ArCo38/Sensors_and_Controls_Board/PCB_Files/Sensor_Integration_Board.kicad_pcb

## KiCad design PCB_Files/Sensor_Integration_Board.kicad_pcb (2026-11-14)

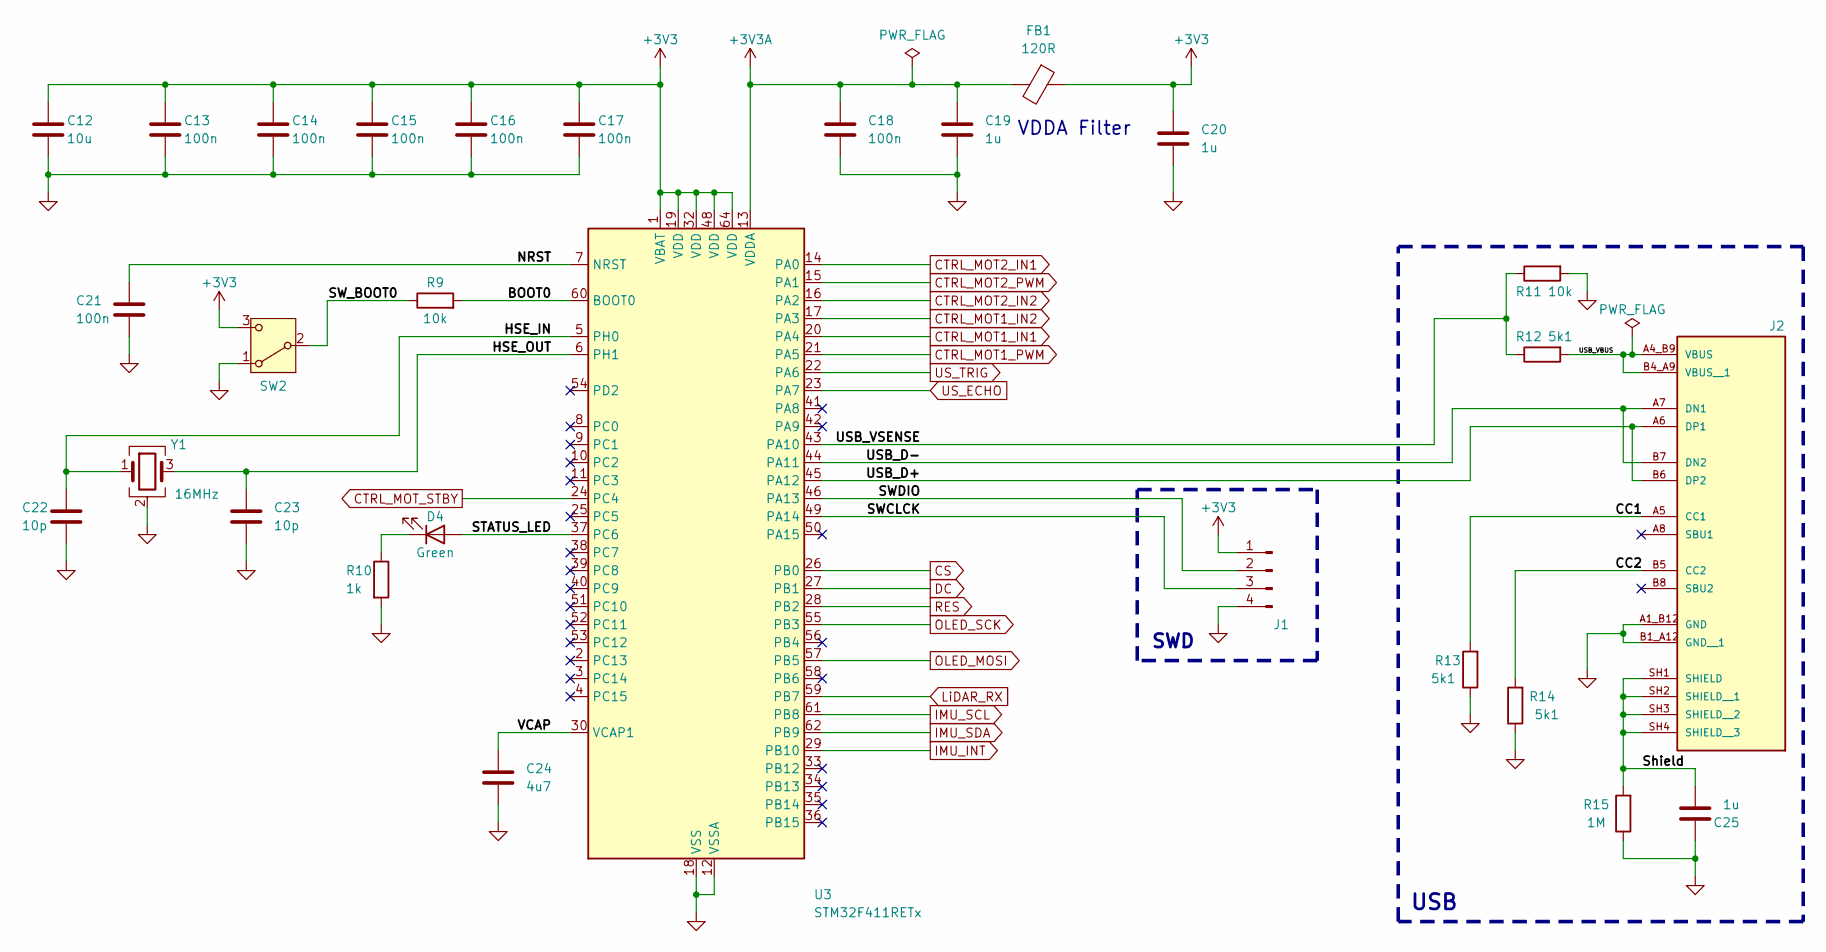
[picture p1: schematic MCU_Schematic.kicad_sch]

Parts:
C12: 10u; C_0805_2012Metric
C13, C14, C15, C16, C17, C18, C21: 100n; C_0603_1608Metric
C19, C20, C25: 1u; C_0805_2012Metric
C22, C23: 10p; C_0603_1608Metric
C24: 4u7; C_0805_2012Metric
D4: Green; LED_0603_1608Metric
FB1: 120R; L_0603_1608Metric
J1: SWD; PinHeader_1x04_P2.54mm_Vertical
J2: UJ20-C-H-G-SMT-4-P16-TR; SAMESKY_UJ20-C-H-G-SMT-4-P16-TR; PARTREV 1.0
R9, R11: 10k; R_0603_1608Metric
R10: 1k; R_0603_1608Metric
R12, R13, R14: 5k1; R_0603_1608Metric
R15: 1M; R_0603_1608Metric
SW2: SW_SPDT; SW_1218_EWI
U3: STM32F411RETx; LQFP-64_10x10mm_P0.5mm
Y1: 16MHz; Crystal_SMD_SeikoEpson_TSX3225-4Pin_3.2x2.5mm

Connections:
+3V3: C12.1, C13.1, C14.1, C15.1, C16.1, C17.1, C20.1, FB1.1, J1.1, SW2.3 (C), U3.1 (VBAT), U3.19 (VDD), U3.32 (VDD), U3.48 (VDD), U3.64 (VDD); also elsewhere on the board
+3V3A: C18.1, C19.1, FB1.2, U3.13 (VDDA)
/MicroController/BOOT0: R9.2, U3.60 (BOOT0)
/MicroController/CC1: J2.A5 (CC1), R13.2
/MicroController/CC2: J2.B5 (CC2), R14.2
/MicroController/HSE_IN: C22.1, U3.5 (PH0), Y1.1
/MicroController/HSE_OUT: C23.1, U3.6 (PH1), Y1.3
/MicroController/NRST: C21.1, U3.7 (NRST)
/MicroController/STATUS_LED: D4.2 (A), U3.37 (PC6)
/MicroController/SWCLCK: J1.3, U3.49 (PA14)
/MicroController/SWDIO: J1.2, U3.46 (PA13)
/MicroController/SW_BOOT0: R9.1, SW2.2 (B)
/MicroController/Shield: C25.1, J2.SH1 (SHIELD), J2.SH2 (SHIELD__1), J2.SH3 (SHIELD__2), J2.SH4 (SHIELD__3), R15.2
/MicroController/USB_D+: J2.A6 (DP1), J2.B6 (DP2), U3.45 (PA12)
/MicroController/USB_D-: J2.A7 (DN1), J2.B7 (DN2), U3.44 (PA11)
/MicroController/USB_VBUS: J2.A4_B9 (VBUS), J2.B4_A9 (VBUS__1), R12.2
/MicroController/USB_VSENSE: R11.1, R12.1, U3.43 (PA10)
/MicroController/VCAP: C24.2, U3.30 (VCAP1)
CS: U3.26 (PB0); also elsewhere on the board
CTRL_MOT1_IN1: U3.20 (PA4); also elsewhere on the board
CTRL_MOT1_IN2: U3.17 (PA3); also elsewhere on the board
CTRL_MOT1_PWM: U3.21 (PA5); also elsewhere on the board
CTRL_MOT2_IN1: U3.14 (PA0); also elsewhere on the board
CTRL_MOT2_IN2: U3.16 (PA2); also elsewhere on the board
CTRL_MOT2_PWM: U3.15 (PA1); also elsewhere on the board
CTRL_MOT_STBY: U3.24 (PC4); also elsewhere on the board
DC: U3.27 (PB1); also elsewhere on the board
GND: C12.2, C13.2, C14.2, C15.2, C16.2, C17.2, C18.2, C19.2, C20.2, C21.2, C22.2, C23.2, C24.1, C25.2, J1.4, J2.A1_B12 (GND), J2.B1_A12 (GND__1), R10.2, R11.2, R13.1, R14.1, R15.1, SW2.1 (A), U3.12 (VSSA), U3.18 (VSS), U3.31 (VSS), U3.47 (VSS), U3.63 (VSS), Y1.2 (G), Y1.4 (G); also elsewhere on the board
IMU_INT: U3.29 (PB10); also elsewhere on the board
IMU_SCL: U3.61 (PB8); also elsewhere on the board
IMU_SDA: U3.62 (PB9); also elsewhere on the board
LiDAR_RX: U3.59 (PB7); also elsewhere on the board
unnamed: D4.1 (K), R10.1
OLED_MOSI: U3.57 (PB5); also elsewhere on the board
OLED_SCK: U3.55 (PB3); also elsewhere on the board
RES: U3.28 (PB2); also elsewhere on the board
US_ECHO: U3.23 (PA7); also elsewhere on the board
US_TRIG: U3.22 (PA6); also elsewhere on the board

Notes on the sheet:
USB
SWD
VDDA Filter

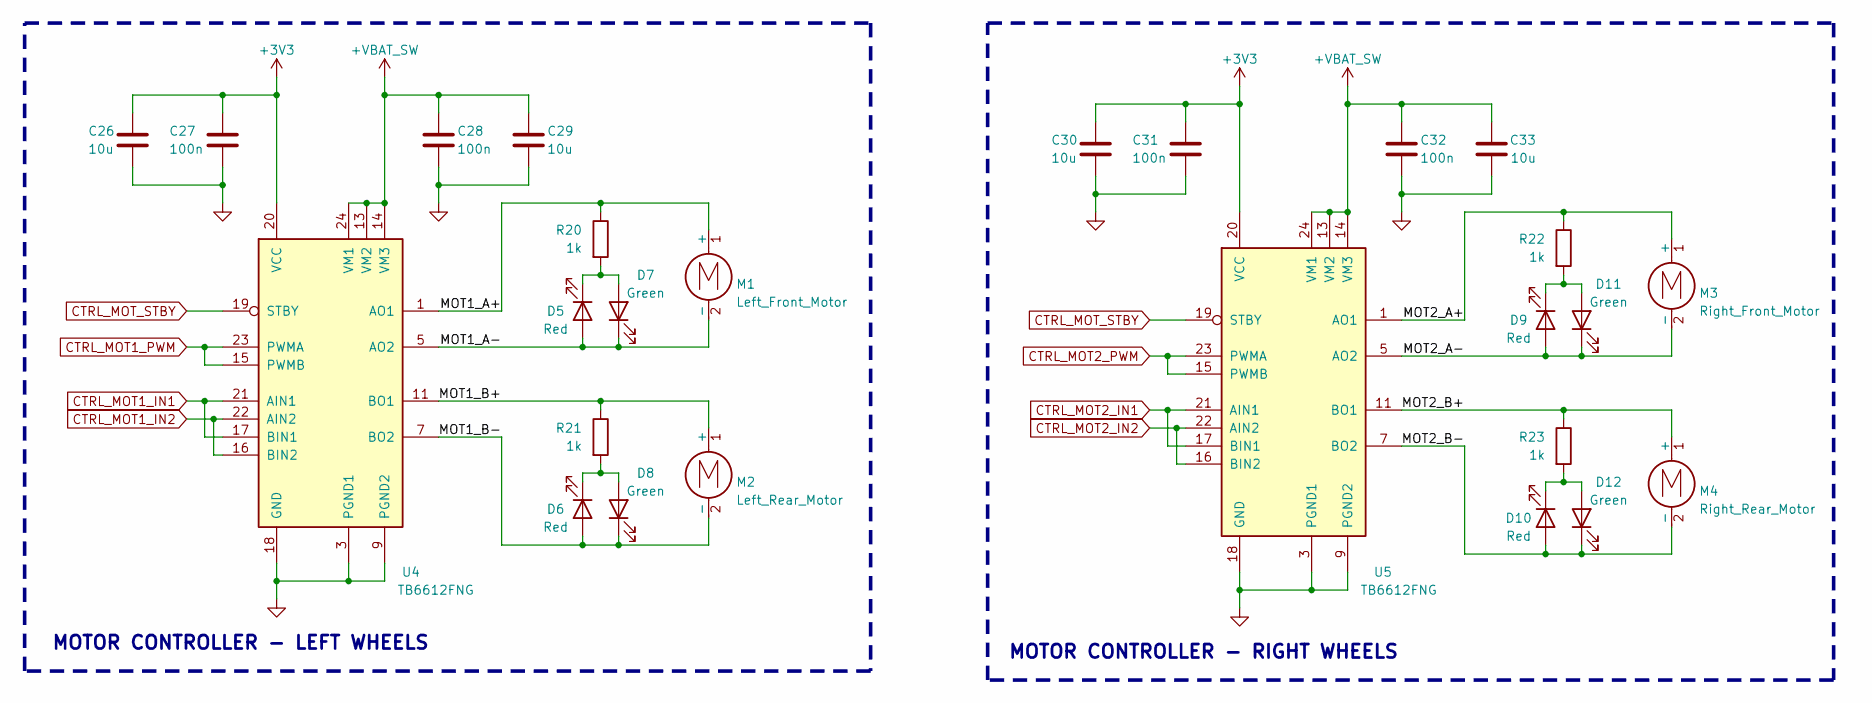
[picture p2: schematic Motor_Controls.kicad_sch]

Parts:
C26, C29, C30, C33: 10u; C_0805_2012Metric
C27, C28, C31, C32: 100n; C_0603_1608Metric
D5, D6, D9, D10: Red; LED_0603_1608Metric
D7, D8, D11, D12: Green; LED_0603_1608Metric
M1: Left_Front_Motor; JST_XH_B2B-XH-A_1x02_P2.50mm_Vertical
M2: Left_Rear_Motor; JST_XH_B2B-XH-A_1x02_P2.50mm_Vertical
M3: Right_Front_Motor; JST_XH_B2B-XH-A_1x02_P2.50mm_Vertical
M4: Right_Rear_Motor; JST_XH_B2B-XH-A_1x02_P2.50mm_Vertical
R20, R21, R22, R23: 1k; R_0603_1608Metric
U4, U5: TB6612FNG; SSOP-24_5.3x8.2mm_P0.65mm

Connections:
+3V3: C26.1, C27.1, C30.1, C31.1, U4.20 (VCC), U5.20 (VCC); also elsewhere on the board
+VBAT_SW: C28.1, C29.1, C32.1, C33.1, U4.13 (VM2), U4.14 (VM3), U4.24 (VM1), U5.13 (VM2), U5.14 (VM3), U5.24 (VM1); also elsewhere on the board
/Motor_Controls/MOT1_A+: M1.1 (+), R20.1, U4.1 (AO1), U4.2 (AO1)
/Motor_Controls/MOT1_A-: D5.2 (A), D7.1 (K), M1.2 (-), U4.5 (AO2), U4.6 (AO2)
/Motor_Controls/MOT1_B+: M2.1 (+), R21.1, U4.11 (BO1), U4.12 (BO1)
/Motor_Controls/MOT1_B-: D6.2 (A), D8.1 (K), M2.2 (-), U4.7 (BO2), U4.8 (BO2)
/Motor_Controls/MOT2_A+: M3.1 (+), R22.1, U5.1 (AO1), U5.2 (AO1)
/Motor_Controls/MOT2_A-: D9.2 (A), D11.1 (K), M3.2 (-), U5.5 (AO2), U5.6 (AO2)
/Motor_Controls/MOT2_B+: M4.1 (+), R23.1, U5.11 (BO1), U5.12 (BO1)
/Motor_Controls/MOT2_B-: D10.2 (A), D12.1 (K), M4.2 (-), U5.7 (BO2), U5.8 (BO2)
CTRL_MOT1_IN1: U4.17 (BIN1), U4.21 (AIN1); also elsewhere on the board
CTRL_MOT1_IN2: U4.16 (BIN2), U4.22 (AIN2); also elsewhere on the board
CTRL_MOT1_PWM: U4.15 (PWMB), U4.23 (PWMA); also elsewhere on the board
CTRL_MOT2_IN1: U5.17 (BIN1), U5.21 (AIN1); also elsewhere on the board
CTRL_MOT2_IN2: U5.16 (BIN2), U5.22 (AIN2); also elsewhere on the board
CTRL_MOT2_PWM: U5.15 (PWMB), U5.23 (PWMA); also elsewhere on the board
CTRL_MOT_STBY: U4.19 (STBY), U5.19 (STBY); also elsewhere on the board
GND: C26.2, C27.2, C28.2, C29.2, C30.2, C31.2, C32.2, C33.2, U4.3 (PGND1), U4.4 (PGND1), U4.9 (PGND2), U4.10 (PGND2), U4.18 (GND), U5.3 (PGND1), U5.4 (PGND1), U5.9 (PGND2), U5.10 (PGND2), U5.18 (GND); also elsewhere on the board
unnamed: D5.1 (K), D7.2 (A), R20.2
unnamed: D6.1 (K), D8.2 (A), R21.2
unnamed: D10.1 (K), D12.2 (A), R23.2
unnamed: D9.1 (K), D11.2 (A), R22.2

Notes on the sheet:
MOTOR CONTROLLER - LEFT WHEELS
MOTOR CONTROLLER - RIGHT WHEELS

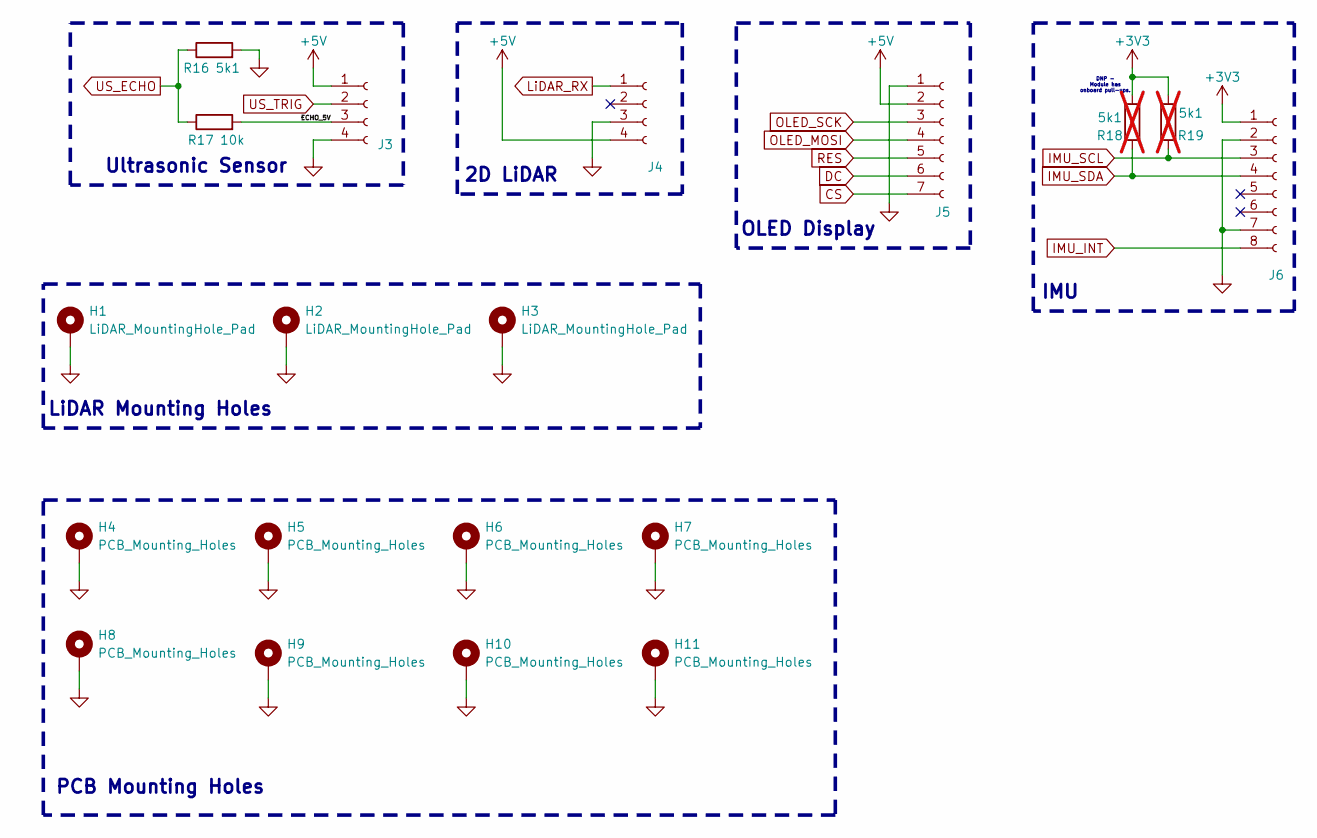
[picture p3: schematic Sensors_and_Peripherals.kicad_sch]

Parts:
H1, H2, H3: LiDAR_MountingHole_Pad; MountingHole_2.7mm_Pad_Via
H4, H5, H6, H7, H8, H9, H10, H11: PCB_Mounting_Holes; MountingHole_3.2mm_M3_Pad_Via
J3: Ultrasonic_Sensor; PinSocket_1x04_P2.54mm_Vertical
J4: 2D_LiDAR; JST_ZH_B4B-ZR_1x04_P1.50mm_Vertical
J5: OLED_Display; PinSocket_1x07_P2.54mm_Vertical
J6: IMU; PinSocket_1x08_P2.54mm_Vertical
R16: 5k1; R_0603_1608Metric
R17: 10k; R_0603_1608Metric
R18, R19: 5k1; R_0603_1608Metric; not fitted

Connections:
+3V3: J6.1, R18.1, R19.1; also elsewhere on the board
+5V: J3.1, J4.4, J5.2; also elsewhere on the board
/Sensors_and_Peripherals/ECHO_5V: J3.3, R17.2
CS: J5.7; also elsewhere on the board
DC: J5.6; also elsewhere on the board
GND: H1.1 (1_1), H2.1 (1_1), H3.1 (1_1), H4.1 (1_1), H5.1 (1_1), H6.1 (1_1), H7.1 (1_1), H8.1 (1_1), H9.1 (1_1), H10.1 (1_1), H11.1 (1_1), J3.4, J4.3, J5.1, J6.2, J6.7, R16.2; also elsewhere on the board
IMU_INT: J6.8; also elsewhere on the board
IMU_SCL: J6.3, R19.2; also elsewhere on the board
IMU_SDA: J6.4, R18.2; also elsewhere on the board
LiDAR_RX: J4.1; also elsewhere on the board
OLED_MOSI: J5.4; also elsewhere on the board
OLED_SCK: J5.3; also elsewhere on the board
RES: J5.5; also elsewhere on the board
US_ECHO: R16.1, R17.1; also elsewhere on the board
US_TRIG: J3.2; also elsewhere on the board

Notes on the sheet:
2D LiDAR
IMU
OLED Display
LiDAR Mounting Holes
Ultrasonic Sensor
PCB Mounting Holes
DNP - Module has onboard pull-ups.

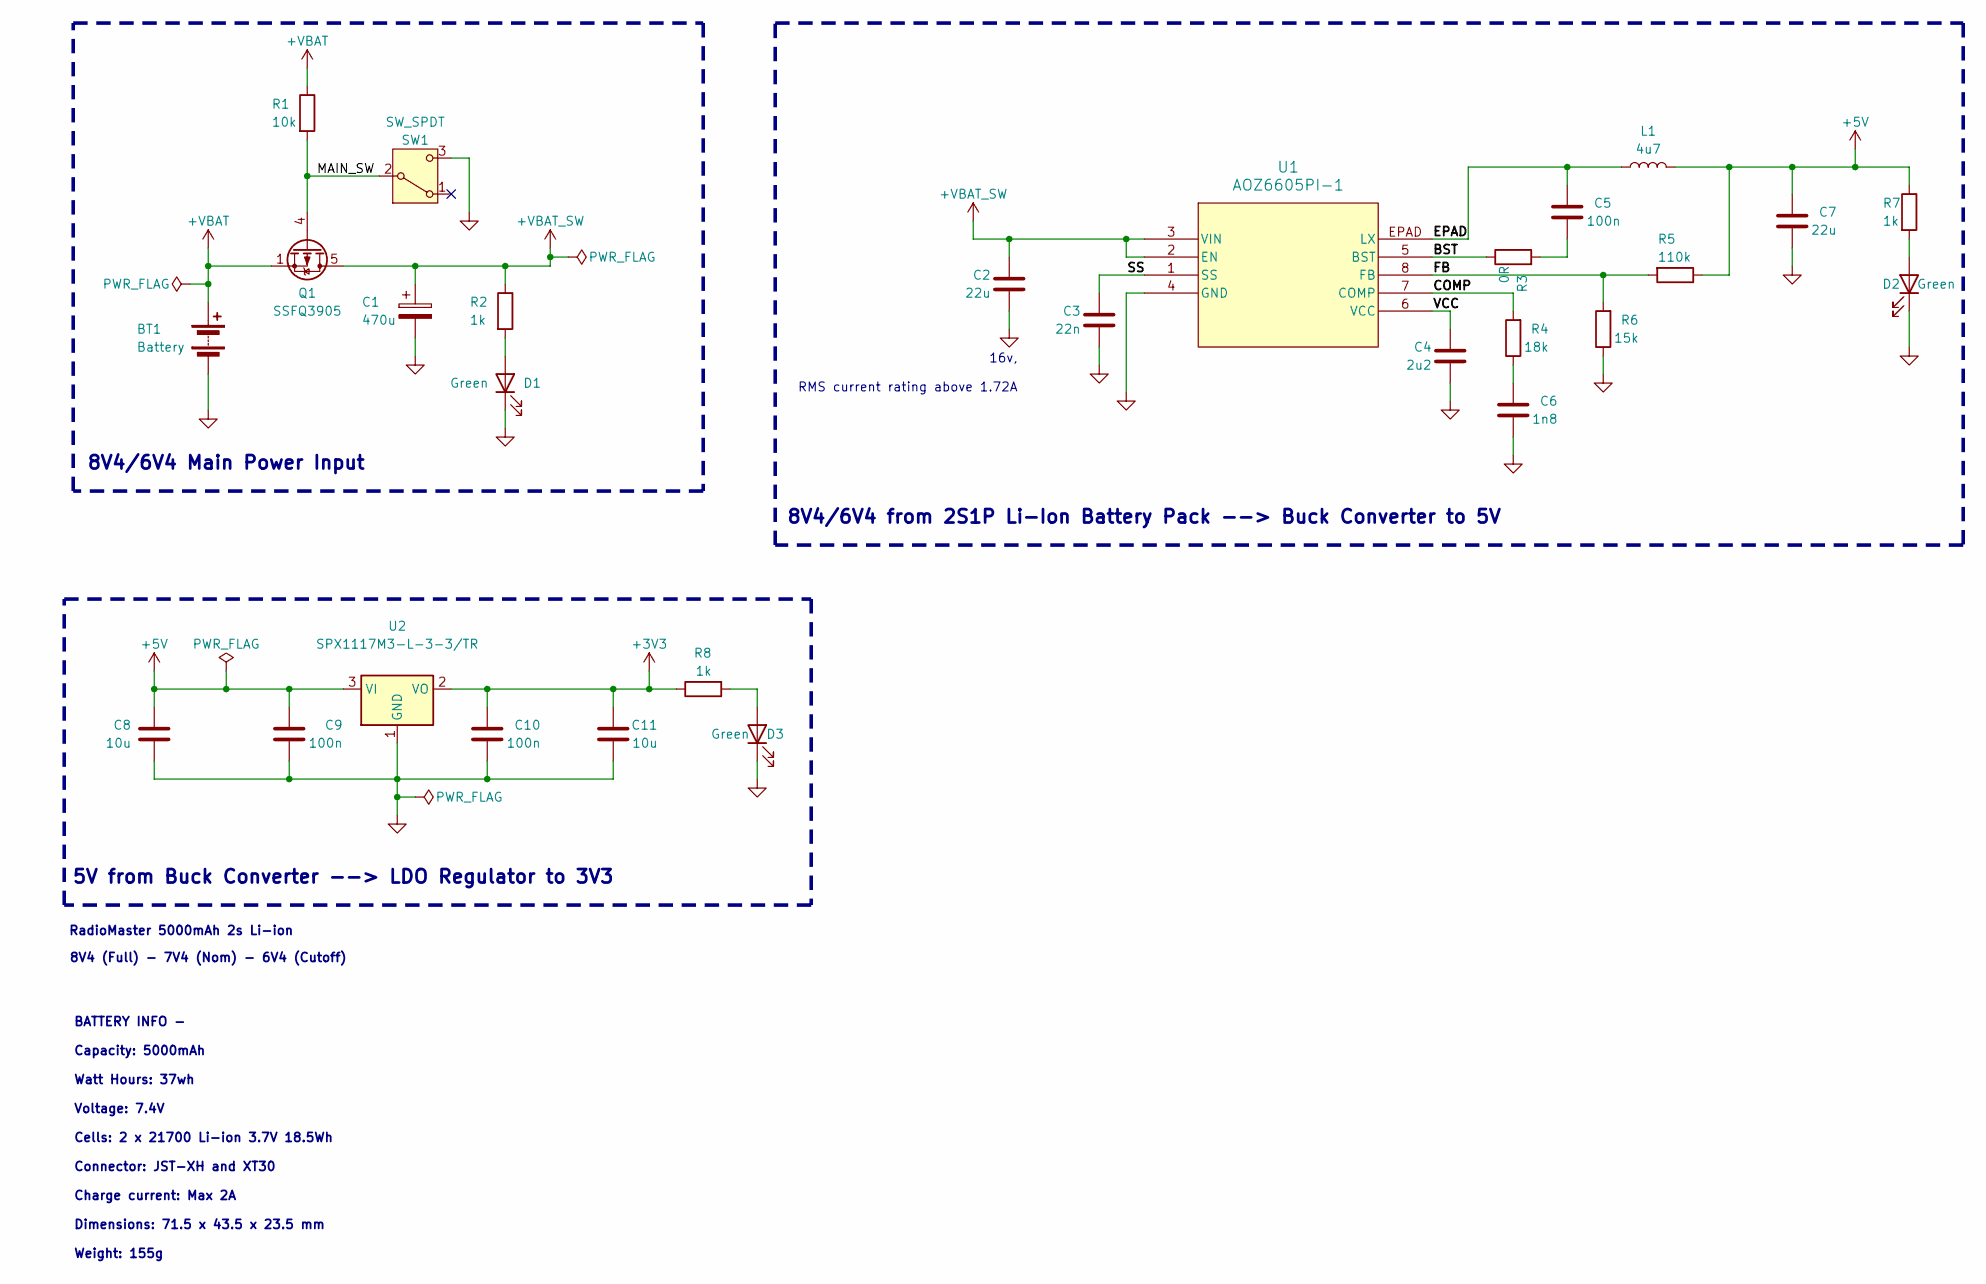
[picture p4: schematic Power_Delivery.kicad_sch]

Parts:
BT1: Battery; AMASS_XT30UPB-M_1x02_P5.0mm_Vertical
C1: 470u; C_0805_2012Metric
C2, C7: 22u; C_0805_2012Metric
C3: 22n; C_0603_1608Metric
C4: 2u2; C_0805_2012Metric
C5, C9, C10: 100n; C_0603_1608Metric
C6: 1n8; C_0603_1608Metric
C8, C11: 10u; C_0805_2012Metric
D1, D2, D3: Green; LED_0603_1608Metric
L1: 4u7; L_0603_1608Metric
Q1: SSFQ3905; SOIC-8_3.9x4.9mm_P1.27mm
R1: 10k; R_0603_1608Metric
R2, R7, R8: 1k; R_0603_1608Metric
R3: 0R; R_0603_1608Metric
R4: 18k; R_0603_1608Metric
R5: 110k; R_0603_1608Metric
R6: 15k; R_0603_1608Metric
SW1: SW_SPDT; SW_1218_EWI
U1: AOZ6605PI-1; SO8_EP1_AOS
U2: SPX1117M3-L-3-3/TR; SOT-223-3_TabPin2

Connections:
+3V3: C10.1, C11.1, R8.1, U2.2 (VO); also elsewhere on the board
+5V: C7.1, C8.1, C9.1, L1.2, R5.1, R7.1, U2.3 (VI); also elsewhere on the board
+VBAT: BT1.1 (+), Q1.1 (S), Q1.2 (S), Q1.3 (S), R1.1
+VBAT_SW: C1.1, C2.1, Q1.5 (D), Q1.6 (D), Q1.7 (D), Q1.8 (D), R2.1, U1.2 (EN), U1.3 (VIN); also elsewhere on the board
/Power_Delivery/BST: R3.1, U1.5 (BST)
/Power_Delivery/COMP: R4.2, U1.7 (COMP)
/Power_Delivery/EPAD: C5.2, L1.1, U1.EPAD (LX)
/Power_Delivery/FB: R5.2, R6.2, U1.8 (FB)
/Power_Delivery/MAIN_SW: Q1.4 (G), R1.2, SW1.2 (B)
/Power_Delivery/SS: C3.1, U1.1 (SS)
/Power_Delivery/VCC: C4.1, U1.6 (VCC)
GND: BT1.2 (-), C1.2, C2.2, C3.2, C4.2, C6.2, C7.2, C8.2, C9.2, C10.2, C11.2, D1.1 (K), D2.1 (K), D3.1 (K), R6.1, SW1.3 (C), U1.4 (GND), U2.1 (GND); also elsewhere on the board
unnamed: C5.1, R3.2
unnamed: C6.1, R4.1
unnamed: D1.2 (A), R2.2
unnamed: D2.2 (A), R7.2
unnamed: D3.2 (A), R8.2

Notes on the sheet:
8V4 (Full) - 7V4 (Nom) - 6V4 (Cutoff)
5V from Buck Converter --> LDO Regulator to 3V3
8V4/6V4 Main Power Input
RadioMaster 5000mAh 2s Li-ion
16v, RMS current rating above 1.72A
BATTERY INFO - Capacity: 5000mAh Watt Hours: 37wh Voltage: 7.4V Cells: 2 x 21700 Li-ion 3.7V 18.5Wh Connector: JST-XH and XT30 Charge current: Max 2A Dimensions: 71.5 x 43.5 x 23.5 mm Weight: 155g
8V4/6V4 from 2S1P Li-Ion Battery Pack --> Buck Converter to 5V

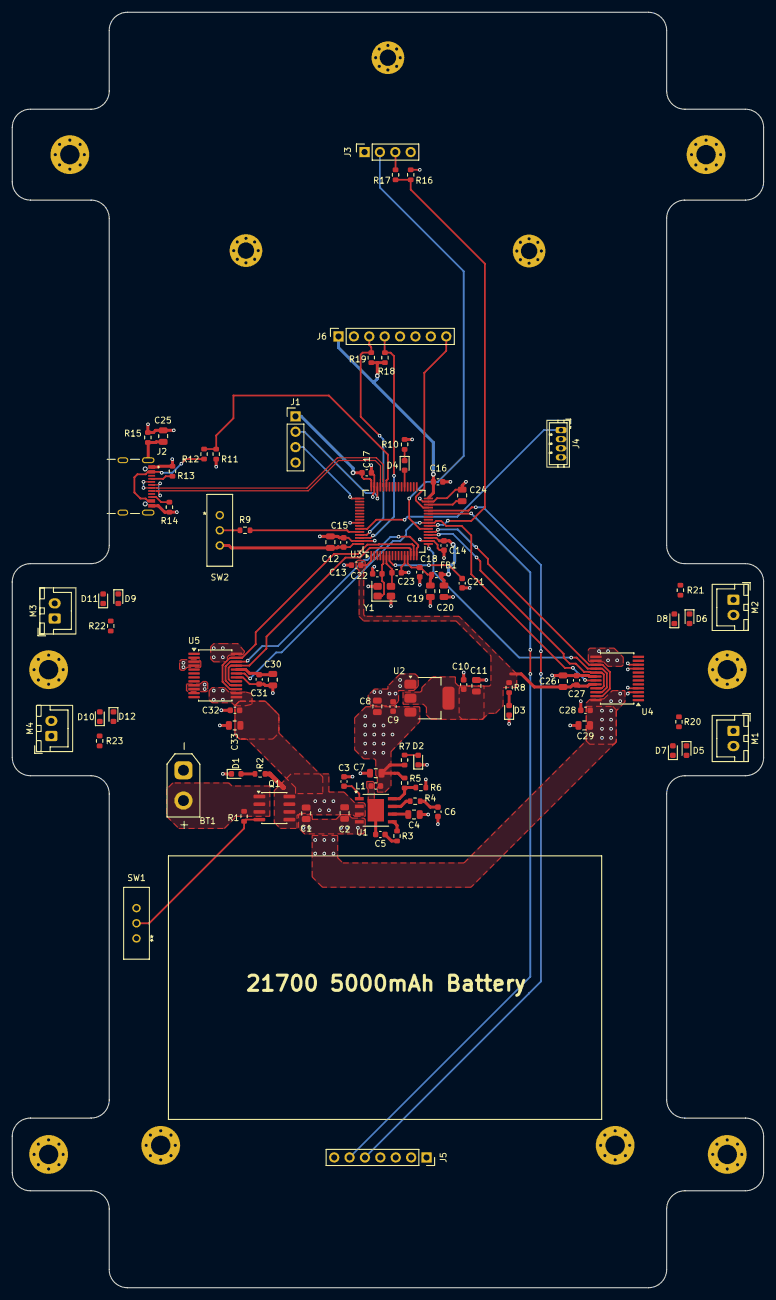
[picture p5: board Sensor_Integration_Board.kicad_pcb from above]

Board: 4 copper layers, 124.0 x 210.5 mm, 101 parts (0 on the bottom side), 66 nets.
