ArCo38/Sensors_and_Controls_Board/firmware/Sensor_Integration_MCU_Config.ioc

Mcu.UserName=STM32F411RETx
PA1.Signal=S_TIM2_CH2
PA11.Signal=USB_OTG_FS_DM
PA12.Signal=USB_OTG_FS_DP
PA13.Signal=SYS_JTMS-SWDIO
PA14.Signal=SYS_JTCK-SWCLK
PA5.Signal=S_TIM2_CH1_ETR
PA7.Signal=S_TIM3_CH2
PB10.Signal=I2C2_SCL
PB3.Signal=SPI1_SCK
PB5.Signal=SPI1_MOSI
PB6.Signal=USART1_TX
PB7.Signal=USART1_RX
PB9.Signal=I2C2_SDA
