ArCo38/Sensors_and_Controls_Board/(commit log)

2026-10-21 feat: initial commit of sensor integration board hardware and mcu configs
    [MCU_Schematic.kicad_sch, Motor_Controls.kicad_sch, Power_Delivery.kicad_sch, Sensor_Integration_Board.kicad_pcb, Sensor_Integration_Board.kicad_sch]
2026-10-21 Swapped all +3.3V and +3.3VA labels to +3V3 and +3V3A lables for clarity.
    [MCU_Schematic.kicad_sch]
2026-10-21 chore: remove KiCad auto-backups from version control
2026-10-23 Changed pin names on MCU sheet for clarity. Example: US_TIM3_CH1 to US_ECHO
    [MCU_Schematic.kicad_sch]
2026-10-24 Began laying out power schematic and motor controller schematic
    [MCU_Schematic.kicad_sch, Motor_Controls.kicad_sch, Power_Delivery.kicad_sch]
2026-10-26 Completed power schematic page. 2S LiPo to buck module to LDO regulator for 3.3v
    [MCU_Schematic.kicad_sch, Power_Delivery.kicad_sch]
2026-10-27 Completed motor control schematic sheet and related MCU pin outs.
    [MCU_Schematic.kicad_sch, Motor_Controls.kicad_sch]
2026-10-27 Cleaned up all ERC errors and warnings due to missing Power Flags or misaligned grid.
    [MCU_Schematic.kicad_sch, Motor_Controls.kicad_sch, Power_Delivery.kicad_sch]
2026-10-27 General schematic clean up and footprint allocation.
    [MCU_Schematic.kicad_sch, Motor_Controls.kicad_sch, Power_Delivery.kicad_sch, Sensor_Integration_Board.kicad_sch]
2026-10-27 Cleaned up battery to buck convertor schematic and added 470u polarized capacitor as a bulk power reservoir.
2026-10-27 Added RadioMaster 2S Battery information to power schematic sheet.
    [Motor_Controls.kicad_sch, Power_Delivery.kicad_sch]
2026-10-28 Cleaned up MCU sheet, added bounding boxes for peripherals.
    [Power_Delivery.kicad_sch]
2026-10-28 Added indicator and debug LED's to various outputs such as buck VOUT, ldo regulator VOUT, motor outputs, and status LED for MCU.
    [MCU_Schematic.kicad_sch, Motor_Controls.kicad_sch, Power_Delivery.kicad_sch]
2026-10-28 Cleaned up MCU schematic by removing speghetti wires and using local net labels instead (Only for some peripherals like sensors and USB.)
    [MCU_Schematic.kicad_sch]
2026-10-28 Cleaned up MCU schematic by seperating power decoupling and main MCU. Added bounding boxes and labels to MCU power decoupling and the MCU itself.
    [MCU_Schematic.kicad_sch]
2026-10-29 Added DNP to IMU pull up resistors due to already being on the module.
    [MCU_Schematic.kicad_sch, Power_Delivery.kicad_sch]
2026-10-29 Cleaned up Bi-directional LED indicator schematic layout for motor controllers.
    [Motor_Controls.kicad_sch, Power_Delivery.kicad_sch]
2026-10-29 Cleaned up motor controller schematic by seperating power decoupling for both motor controllers, seperated SGND and PGND, and rearranged input pin wiring for clearity.
    [Motor_Controls.kicad_sch]
2026-10-29 Added MOT_STBY output from MCU pin 24 to enable low-power sleep state on motor controllers.
    [MCU_Schematic.kicad_sch, Motor_Controls.kicad_sch]
2026-10-29 Changed +BATT net name to +VBAT, +BATT_SW to +VBAT_SW, and now motor controllers are powered by net name +VBAT_SW. This clearly seperates +VBAT before the switch, +VBAT_SW after the switch, +5V, and 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
    [MCU_Schematic.kicad_sch, Motor_Controls.kicad_sch, Power_Delivery.kicad_sch]
2026-10-30 Added IC buck converter symbol and footprint to schematic. Will create own buck converter design on board.
    [MCU_Schematic.kicad_sch, Motor_Controls.kicad_sch, Power_Delivery.kicad_sch]
2026-10-31 Did calculations on switching buck converter circuit components.
    [Power_Delivery.kicad_sch]
2026-11-01 Completed AOZ6605PI-1 IC buck converter schematic layout.
    [Power_Delivery.kicad_sch]
2026-11-01 Completed power schematic refactor by deleting buck converter module remenants from power input circuit and labeling each area.
    [Power_Delivery.kicad_sch]
2026-11-01 Completed schematic capture. Finished power layout.
    [MCU_Schematic.kicad_sch, Power_Delivery.kicad_sch]
2026-11-01 Added P-Channel mosfet as main power switch. Finding a proper switch was too annoying.
    [MCU_Schematic.kicad_sch, Motor_Controls.kicad_sch, Power_Delivery.kicad_sch, Sensor_Integration_Board.kicad_pcb]
2026-11-01 Finalized schematic capture and did some clean up. Organized reference labels.
    [MCU_Schematic.kicad_sch, Motor_Controls.kicad_sch, Power_Delivery.kicad_sch, Sensor_Integration_Board.kicad_sch]
2026-11-01 Changed pin configurations for IMU and Ultrasonic sensor. IMU now has an 8 pin socket and the Ultrasonic sensor had its pins swapped to match physical pinout. Also changed TIM3 input capture pin to P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
    [MCU_Schematic.kicad_sch, Power_Delivery.kicad_sch]
2026-11-01 Changed IMU footprint to 8 pin socket.
    [MCU_Schematic.kicad_sch]
2026-11-01 Added the top plate outline as the edge cut layer.
    [Sensor_Integration_Board.kicad_pcb]
2026-11-02 Added LiDAR moutning points to top plate, added 4 layer stackup and stackup labels.
    [MCU_Schematic.kicad_sch, Power_Delivery.kicad_sch, Sensor_Integration_Board.kicad_pcb]
2026-11-02 Added all custom footprints and symbols. Placed all components into pcb designer.
    [MCU_Schematic.kicad_sch, Motor_Controls.kicad_sch, Power_Delivery.kicad_sch, Sensor_Integration_Board.kicad_pcb, Sensor_Integration_Board.kicad_sch]
2026-11-02 Split MCU and peripherals into two different sheets.S Solved some schematic ERC issues with footprints and USB-C VBUS, missing powerflag.
    [MCU_Schematic.kicad_sch, Power_Delivery.kicad_sch, Sensor_Integration_Board.kicad_pcb, Sensor_Integration_Board.kicad_sch, Sensors_and_Peripherals.kicad_sch]
2026-11-03 Finished board mounting holes to align with premade bottom plate of robot kit.
    [MCU_Schematic.kicad_sch, Sensor_Integration_Board.kicad_pcb, Sensors_and_Peripherals.kicad_sch]
2026-11-03 Added 3d models for switches, and added 3mm spacing from left and right of mounting holes. May push to 3.5mm.
    [Sensor_Integration_Board.kicad_pcb]
2026-11-04 Began pcb component placement.
    [MCU_Schematic.kicad_sch, Motor_Controls.kicad_sch, Power_Delivery.kicad_sch, Sensor_Integration_Board.kicad_pcb, Sensor_Integration_Board.kicad_sch, Sensors_and_Peripherals.kicad_sch]
2026-11-05 Redid footprints and symbols libraries. Added 2.42 OLED display 3D model to the pcb.
    [MCU_Schematic.kicad_sch, Power_Delivery.kicad_sch, Sensor_Integration_Board.kicad_pcb, Sensors_and_Peripherals.kicad_sch]
2026-11-06 Replaced all gndpwr symbols with regular gnd. Ground plane seperation too complicated and unnecessary.
    [Motor_Controls.kicad_sch, Power_Delivery.kicad_sch, Sensor_Integration_Board.kicad_pcb]
2026-11-06 Added 3D models for peripherals and sensors. Added keepout area for 21700 battery pack.
    [MCU_Schematic.kicad_sch, Motor_Controls.kicad_sch, Sensor_Integration_Board.kicad_pcb]
2026-11-07 Finished rough placement of components. Added copper planes for L2 and L3.
    [Sensor_Integration_Board.kicad_pcb, Sensors_and_Peripherals.kicad_sch]
2026-11-07 Completed VBAT to switching regulator power traces.
    [Power_Delivery.kicad_sch, Sensor_Integration_Board.kicad_pcb]
2026-11-07 Routed power for motor controller VIN pins and routed poewr for +5V into LDO.
    [Sensor_Integration_Board.kicad_pcb]
2026-11-09 Redoing routing as original layout had too many crossing lines. Will focus on preventing the ratsnest from the start and look into tradeoffs.
    [MCU_Schematic.kicad_sch, Sensor_Integration_Board.kicad_pcb]
2026-11-09 Began routing power. Started with the switching regulator circuit.
    [Sensor_Integration_Board.kicad_pcb]
2026-11-11 Implemented power drops from L1 to L4 using vias to save space for signals above on L1.
    [Sensor_Integration_Board.kicad_pcb]
2026-11-11 Routed power to motor controller 2 and refined via spacing at 1.5mm center to center.
    [Sensor_Integration_Board.kicad_pcb]
2026-11-11 Completed copper pours for power areas. Completed USBC routing.
    [Sensor_Integration_Board.kicad_pcb]
2026-11-12 Routed IMU, SWD, and half of U5 has been complete. Only motor output pins remain.
    [Sensor_Integration_Board.kicad_pcb]
2026-11-13 Restarted the edge cuts layer. Board was slightly misaligned from the start due to slight dxf import scaling issues.
    [MCU_Schematic.kicad_sch, Sensor_Integration_Board.kicad_pcb, Sensors_and_Peripherals.kicad_sch]
2026-11-14 Finished top plate redesign. When importing from autocad, the dimensions were scalled slightly off.
    [Sensor_Integration_Board.kicad_pcb]
2026-11-14 Edge cuts layer was filled, but when filleting the corners they were not aligned. Redid the entire connection and filleted the edge cut properly.
    [Sensor_Integration_Board.kicad_pcb]
2026-11-14 Completed input side of both motors.
    [Sensor_Integration_Board.kicad_pcb]
2026-11-14 Routed DC nad RES traces for OLED display.
    [Sensor_Integration_Board.kicad_pcb]
